hidaka301/TKG_Wiki/02_詳細検討/21_電流検出基板/回路図.pdf

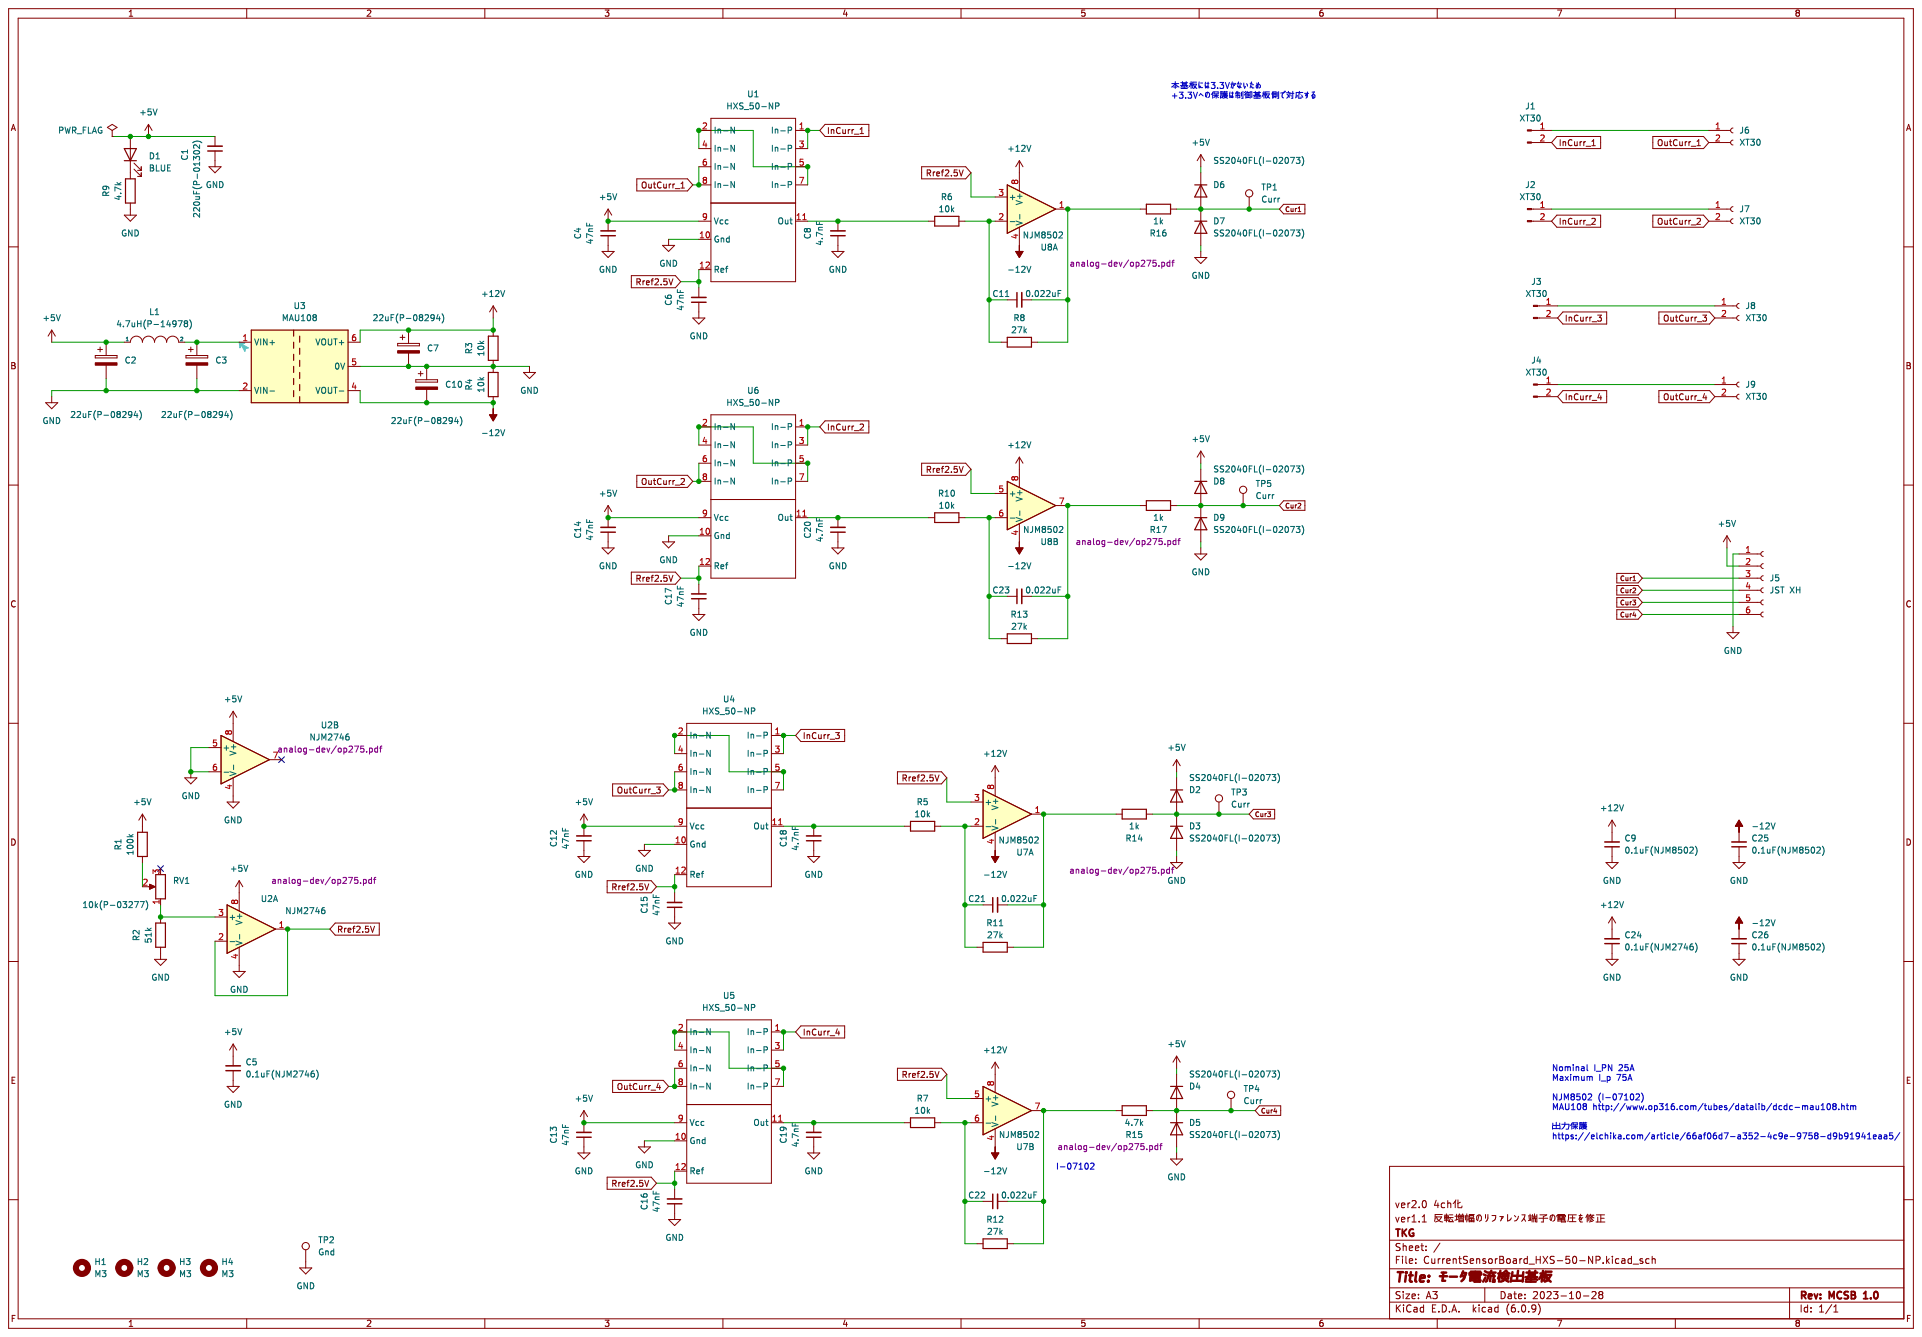
[picture p40: page 1]
