hidaka301/TKG_Wiki/02_詳細検討/20_パワー電源制御基板/ECcircuit.kicad_pcb

## KiCad design 02_詳細検討/20_パワー電源制御基板/ECcircuit.kicad_pcb (2024-03-31)

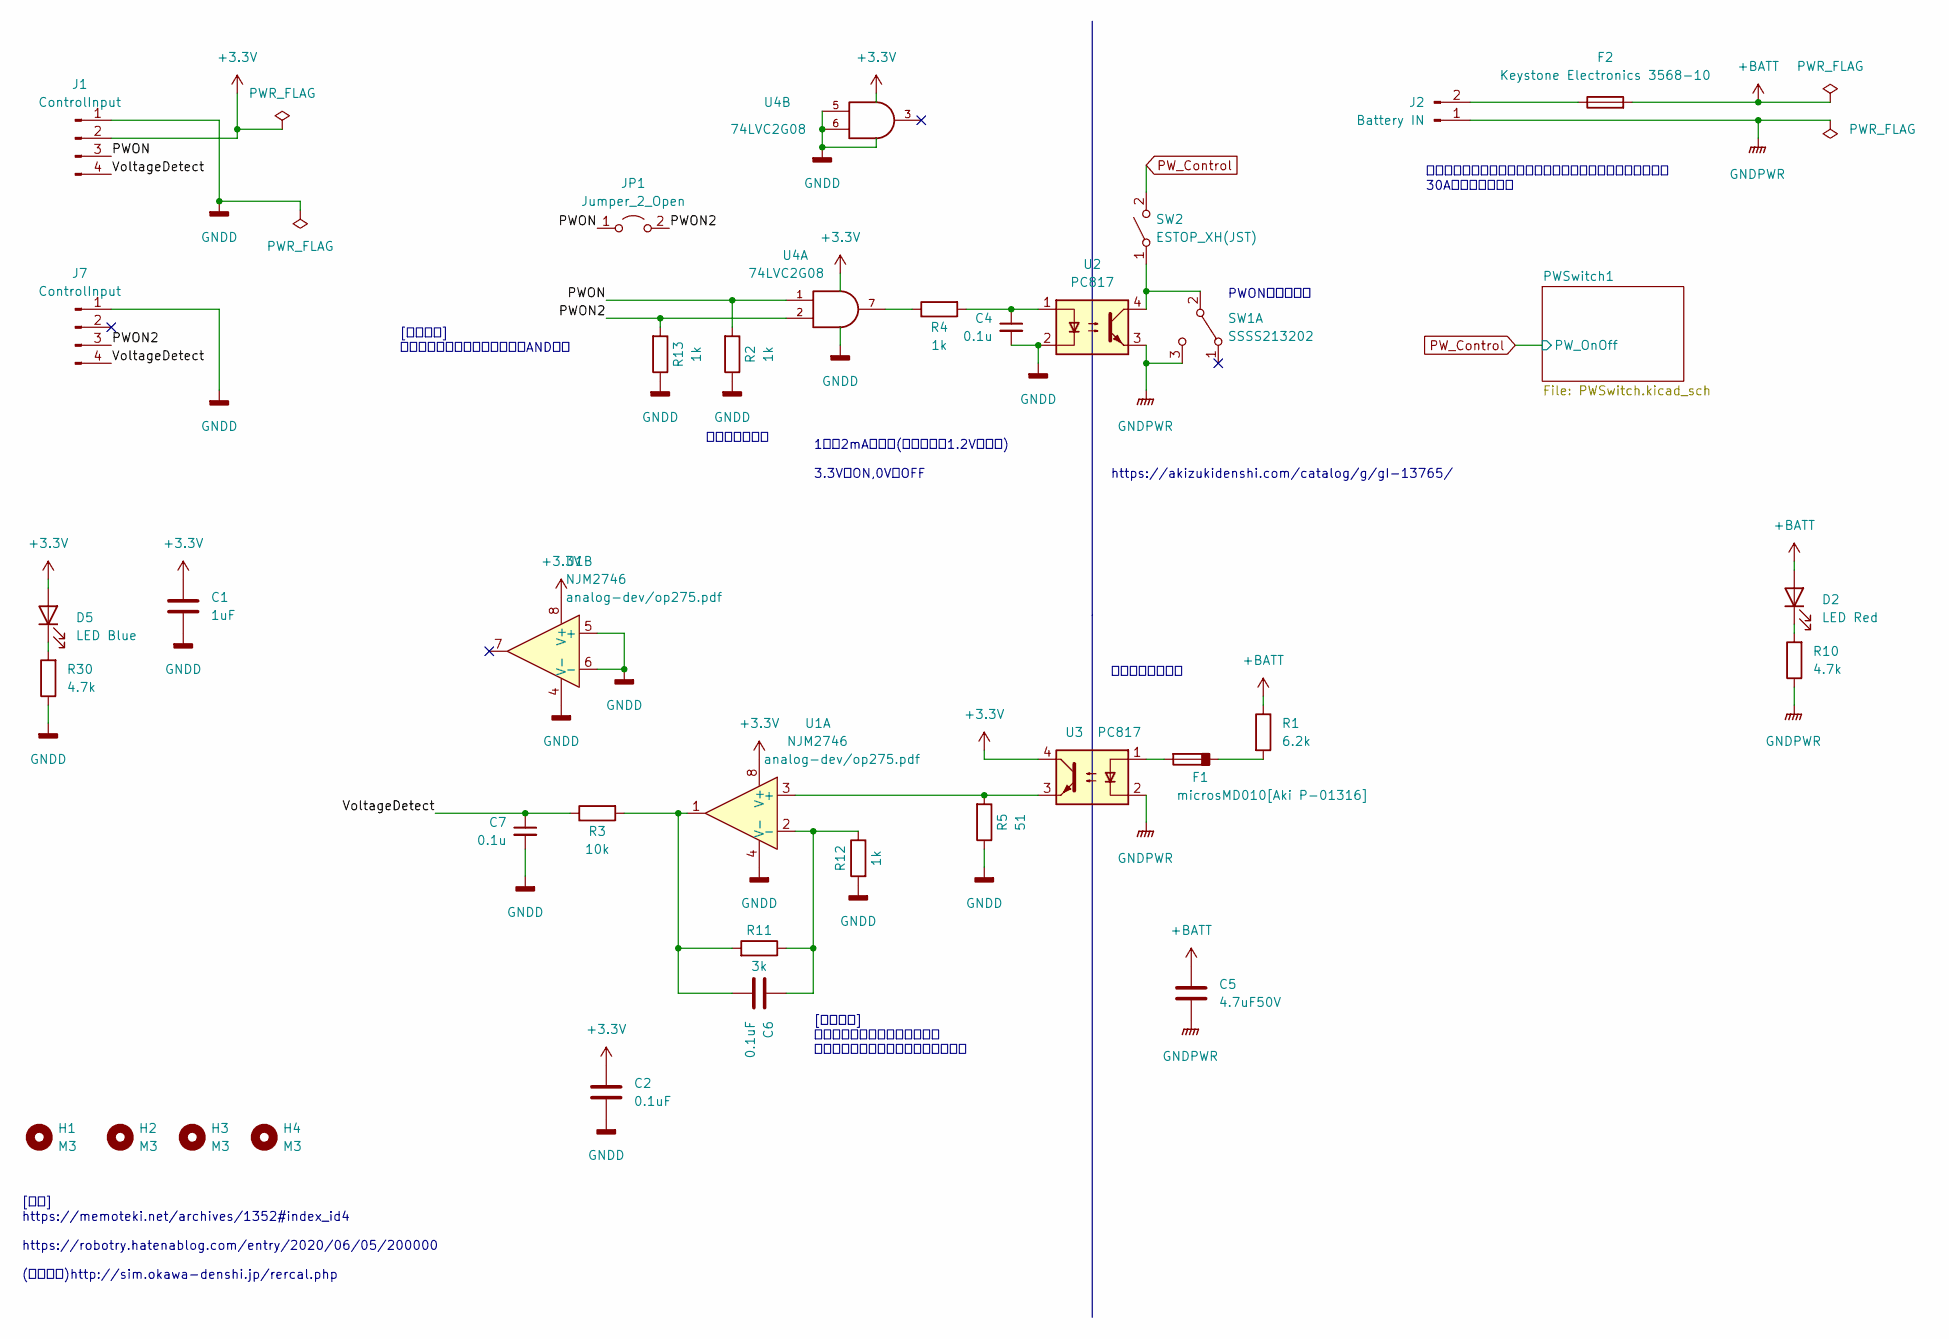
[picture p46: schematic ECcircuit.kicad_sch, 電源制御基板]

Parts:
C1: 1uF; C_0603_1608Metric_Pad1.08x0.95mm_HandSolder
C2, C6: 0.1uF; C_0603_1608Metric_Pad1.08x0.95mm_HandSolder
C4, C7: 0.1u; C_0402_1005Metric_Pad0.74x0.62mm_HandSolder
C5: 4.7uF50V; C_0805_2012Metric_Pad1.18x1.45mm_HandSolder
D2: LED Red; D_0603_1608Metric_Pad1.05x0.95mm_HandSolder
D5: LED Blue; D_0603_1608Metric_Pad1.05x0.95mm_HandSolder
F1: microsMD010[Aki P-01316]; Fuse_1812_4532Metric_Pad1.30x3.40mm_HandSolder
F2: Keystone Electronics 3568-10; Fuseholder_Blade_Mini_Keystone_3568
H1, H2, H3, H4: M3; MountingHole_3.2mm_M3
J1, J7: ControlInput; JST_XH_B4B-XH-A_1x04_P2.50mm_Vertical
J2: Battery IN; AMASS_XT60-M_1x02_P7.20mm_Vertical
JP1: Jumper_2_Open; SolderJumper-2_P1.3mm_Open_TrianglePad1.0x1.5mm
R1: 6.2k; R_0603_1608Metric_Pad0.98x0.95mm_HandSolder
R2, R4, R12, R13: 1k; R_0603_1608Metric_Pad0.98x0.95mm_HandSolder
R3: 10k; R_0603_1608Metric_Pad0.98x0.95mm_HandSolder
R5: 51; R_0603_1608Metric_Pad0.98x0.95mm_HandSolder
R10, R30: 4.7k; R_0603_1608Metric_Pad0.98x0.95mm_HandSolder
R11: 3k; R_0603_1608Metric_Pad0.98x0.95mm_HandSolder
SW1: SSSS213202
SW2: ESTOP_XH(JST); JST_XH_B2B-XH-A_1x02_P2.50mm_Vertical
U1: NJM2746; SO-8_5.3x6.2mm_P1.27mm
U2, U3: PC817; DIP-4_W7.62mm
U4: 74LVC2G08; SSOP-8_2.95x2.8mm_P0.65mm

Connections:
+3.3V: C1.1, C2.1, D5.2 (A), J1.2, U1.8 (V+), U3.4, U4.8 (VCC)
+BATT: C5.1, D2.2 (A), F2.2, R1.1; also elsewhere on the board
/PWON: J1.3, JP1.1 (A), R2.2, U4.1
/PWON2: J7.3, JP1.2 (B), R13.2, U4.2
/VoltageDetect: C7.1, J1.4, J7.4, R3.1
GND: C1.2, C2.2, C4.2, C7.2, J1.1, J7.1, R2.1, R5.1, R12.2, R13.1, R30.1, U1.4 (V-), U1.5 (+), U1.6 (-), U2.2, U4.4 (GND), U4.5, U4.6
GNDPWR: C5.2, J2.1, R10.1, SW1.3 (C), U2.3, U3.2; also elsewhere on the board
unnamed: C4.1, R4.2, U2.1
unnamed: C6.1, R11.1, R12.1, U1.2 (-)
unnamed: C6.2, R3.2, R11.2, U1.1
unnamed: D2.1 (K), R10.2
unnamed: D5.1 (K), R30.2
unnamed: F1.1, R1.2
unnamed: F1.2, U3.1
unnamed: F2.1, J2.2
unnamed: R4.1, U4.7
unnamed: R5.2, U1.3 (+), U3.3
unnamed: SW1.2 (B), SW2.1 (A), U2.4
PW_Control: SW2.2 (B); also elsewhere on the board

Notes on the sheet:
ヒューズの代わりに電流センサを入れれば、電流計測も可能 30A定格な点に注意
PWON信号無視用
[参考] https://memoteki.net/archives/1352#index_id4 https://robotry.hatenablog.com/entry/2020/06/05/200000 (分圧抵抗)http://sim.okawa-denshi.jp/rercal.php
https://akizukidenshi.com/catalog/g/gI-13765/
[次回改訂] 電圧の変換精度と再現性が悪い 素直に絶縁のオペアンプでも使うべき
1次側2mAとする(順方向電圧1.2Vで計算) 3.3V：ON,0V：OFF
ﾌﾟﾙﾀﾞｳﾝ
バッテリ電圧検出
[次回改訂] オープンドレイン入力にすればAND不要
