hidaka301/TKG_Wiki/02_詳細検討/20_パワー電源制御基板/ECcircuit.kicad_pcb

## KiCad design 02_詳細検討/20_パワー電源制御基板/ECcircuit.kicad_pcb (continued)

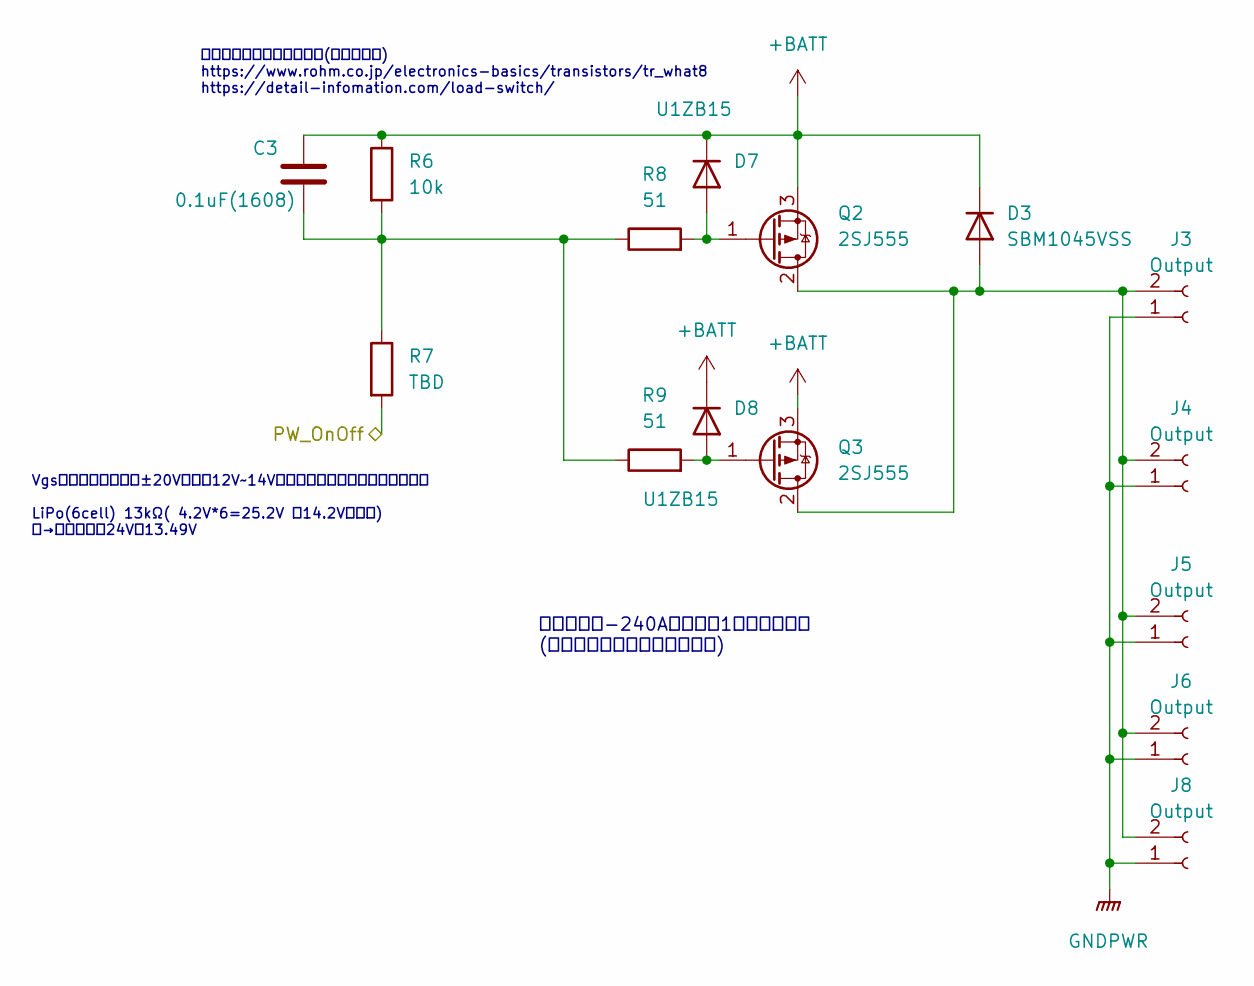
[picture p47: schematic PWSwitch.kicad_sch]

Parts:
C3: 0.1uF(1608); C_0603_1608Metric_Pad1.08x0.95mm_HandSolder
D3: SBM1045VSS; D_DO-201_P15.24mm_Horizontal
D7, D8: U1ZB15; D_SMB_Handsoldering
J3, J4, J5: Output; AMASS_XT60-F_1x02_P7.20mm_Vertical
J6, J8: Output; AMASS_XT30U-F_1x02_P5.0mm_Vertical
Q2, Q3: 2SJ555; TO-3P-3_Vertical
R6: 10k; R_0603_1608Metric_Pad0.98x0.95mm_HandSolder
R7: TBD; R_0603_1608Metric_Pad0.98x0.95mm_HandSolder
R8, R9: 51; R_0603_1608Metric_Pad0.98x0.95mm_HandSolder

Connections:
+BATT: C3.1, D3.1 (K), D7.1 (K), D8.1 (K), Q2.3 (S), Q3.3 (S), R6.1; also elsewhere on the board
GNDPWR: J3.1, J4.1, J5.1, J6.1, J8.1; also elsewhere on the board
unnamed: C3.2, R6.2, R7.1, R8.1, R9.1
unnamed: D3.2 (A), J3.2, J4.2, J5.2, J6.2, J8.2, Q2.2 (D), Q3.2 (D)
unnamed: D7.2 (A), Q2.1 (G), R8.2
unnamed: D8.2 (A), Q3.1 (G), R9.2
PW_Control: R7.2; also elsewhere on the board

Notes on the sheet:
突入電流防止用コンデンサ(ソフト充電) https://www.rohm.co.jp/electronics-basics/transistors/tr_what8 https://detail-infomation.com/load-switch/
Vgsの絶対最大定格が±20Vなので12V~14Vとなるような抵抗を選定すること LiPo(6cell) 13kΩ( 4.2V*6=25.2V で14.2Vとなる) →実測結果は24V時13.49V
せん頭電流-240Aのため、1個で問題ない (異常に対する対処はヒューズ)

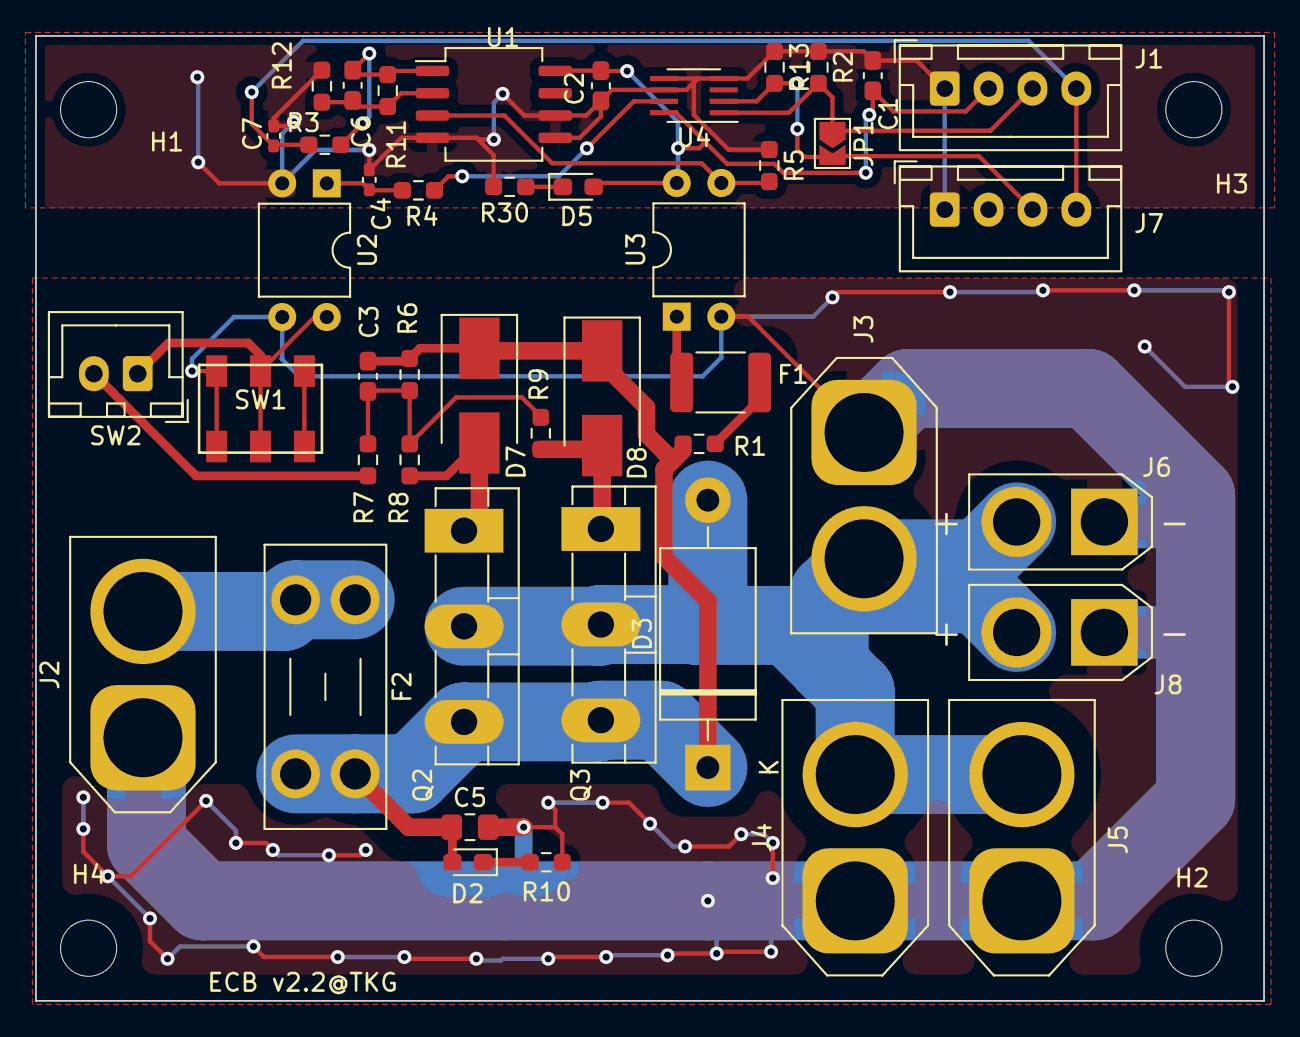
[picture p48: board ECcircuit.kicad_pcb from above]

Board: 2 copper layers, 70.0 x 55.0 mm, 49 parts (0 on the bottom side), 23 nets.
