hidaka301/TKG_Wiki/(commit log)

2023-04-09 update 設計資料追加
    [外部仕様書_射出制御系(外部インターフェース)_ver2.00.xlsx, 外部仕様書_走行制御系_ver2.00.xlsx, 機能ブロック図_2023プレ大会機.xlsx, 駆動系メカ仕様検討.xlsx]
2024-03-31 add 2023の基板CADデータを追加
    [CH1.kicad_sch, CurrentSensorBoard_HXS-50-NP.kicad_pcb, CurrentSensorBoard_HXS-50-NP.kicad_sch, DataTransfer.kicad_sch, ECcircuit.kicad_pcb, ECcircuit.kicad_sch, EncoderIF.kicad_sch, PWSwitch.kicad_sch]
